coder7676mit/Digital-Function-Generator-Using-LPC1768-microcontroller/Inc/waveforms.h

#ifndef WAVEFORMS_H
#define WAVEFORMS_H

#include <stdint.h>

#define LUT_SIZE 256
#define DAC_MAX  1023

/* 256 samples/cycle, 10-bit unsigned DAC values: 0..1023 */

static const uint16_t sine_lut[LUT_SIZE] = {
    512, 524, 537, 549, 562, 574, 587, 599, 611, 624, 636, 648, 660, 672, 684, 696,
    707, 719, 730, 741, 753, 764, 774, 785, 796, 806, 816, 826, 836, 846, 855, 864,
    873, 882, 890, 899, 907, 915, 922, 930, 937, 944, 950, 957, 963, 968, 974, 979,
    984, 989, 993, 997, 1001, 1004, 1008, 1011, 1013, 1015, 1017, 1019, 1021, 1022, 1022, 1023,
    1023, 1023, 1022, 1022, 1021, 1019, 1017, 1015, 1013, 1011, 1008, 1004, 1001, 997, 993, 989,
    984, 979, 974, 968, 963, 957, 950, 944, 937, 930, 922, 915, 907, 899, 890, 882,
    873, 864, 855, 846, 836, 826, 816, 806, 796, 785, 774, 764, 753, 741, 730, 719,
    707, 696, 684, 672, 660, 648, 636, 624, 611, 599, 587, 574, 562, 549, 537, 524,
    512, 499, 486, 474, 461, 449, 436, 424, 412, 399, 387, 375, 363, 351, 339, 327,
    316, 304, 293, 282, 270, 259, 249, 238, 227, 217, 207, 197, 187, 177, 168, 159,
    150, 141, 133, 124, 116, 108, 101, 93, 86, 79, 73, 66, 60, 55, 49, 44,
    39, 34, 30, 26, 22, 19, 15, 12, 10, 8, 6, 4, 2, 1, 1, 0,
    0, 0, 1, 1, 2, 4, 6, 8, 10, 12, 15, 19, 22, 26, 30, 34,
    39, 44, 49, 55, 60, 66, 73, 79, 86, 93, 101, 108, 116, 124, 133, 141,
    150, 159, 168, 177, 187, 197, 207, 217, 227, 238, 249, 259, 270, 282, 293, 304,
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
    0, 0, 0, 0, 0, 0, 0, 0, 0, 0, 0, 0, 0, 0, 0, 0,
    0, 0, 0, 0, 0, 0, 0, 0, 0, 0, 0, 0, 0, 0, 0, 0,
    0, 0, 0, 0, 0, 0, 0, 0, 0, 0, 0, 0, 0, 0, 0, 0,
    0, 0, 0, 0, 0, 0, 0, 0, 0, 0, 0, 0, 0, 0, 0, 0,
    0, 0, 0, 0, 0, 0, 0, 0, 0, 0, 0, 0, 0, 0, 0, 0,
};

#endif
