coder7676mit/Digital-Function-Generator-Using-LPC1768-microcontroller/(commit log)

2026-11-08 Waveform generator: GPDMA/DAC output + GPIO-interrupt waveform switching
    - 96 MHz system clock via PLL0 from the 12 MHz external crystal
    - 256-point, 10-bit sine/triangle/sawtooth/square LUTs in waveforms.h
    - GPDMA channel 0 streams a LUT to the DAC via a self-referencing
    (circular) linked-list item, so output runs with zero CPU involvement
    once started
    - DAC_SetFrequency() derives the DAC's internal DACCNTVAL reload from
    96,000,000 / (freq * samples)
    - Waveform selection driven by a single GPIO pin (P2.0) configured as a
    rising-edge interrupt: each pulse to 3.3V cycles to the next waveform
    - Fixed 15 kHz output for this stage; amplitude not yet adjustable
    [dac.c, dac.h, main.c, waveforms.h]
2026-11-08 Replace GPIO-interrupt switching with a 4x4 keypad; add amplitude control
    A single interrupt pin can only step through a fixed sequence of
    waveforms and can't address more than one parameter, so local control
    moves to a polled 4x4 matrix keypad instead:
    1/2/3/4 = sine/triangle/sawtooth/square
    A/B = frequency +/- 500 Hz (10 Hz-15 kHz, clamped)
    C/D = amplitude +/- 10%
    DAC_DMA_Start() now scales each LUT sample by the selected amplitude
    (1-10, i.e. 10%-100%) before it's copied into the DMA buffer: centre
    on the DAC's mid-scale value (512), scale, restore the offset. LCD
    shows waveform, frequency and amplitude, refreshed only when a value
    actually changes.
    [dac.c, main.c]
2026-11-08 Add UART0 remote control (interrupt-driven)
    UART0_Init() configures P0.2/P0.3 as TXD0/RXD0, PCLK_UART0 = CCLK
    (96 MHz), and DLL=52 for 115200 baud (8-N-1). Unlike the keypad, this
    path is a genuine hardware RX interrupt: UART0_IRQHandler() buffers
    characters into rx_buffer and sets command_ready on \r/\n, touching
    nothing but that buffer, rx_index and the flag -- it never writes to
    the DAC or DMA registers directly.
    The main loop parses a ready line with atoi() and applies it through
    the same DAC_DMA_Start() path the keypad uses:
    F<freq> e.g. F15000 -> set frequency (10-15000 Hz)
    W<1-4> e.g. W2 -> select waveform
    A<1-10> e.g. A9 -> set amplitude (10%-100%)
    Tested from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
2026-11-08 Add Keil project files, documentation and final report
    - keil-project/: exp02.uvproj + exp02.sct to reopen/rebuild in Keil
    MDK-ARM
    - docs/report.pdf: full mini-project report (methodology, DMA/LLI and
    UART design detail, bench results, references)
    - docs/images/: system block diagram, hardware setup, and oscilloscope
    captures at the two ends of the supported frequency range
    - README with pinout, build steps, keypad/UART command reference and
    results
